je1rav/ADX-S_trusdx-audio/README.md

# ADX-S（CRkits共同購入プロジェクト）の改造

 CRkits共同購入プロジェクトで頒布されているADX-S FT8トランシーバ （https://jl1kra.sakura.ne.jp/ADX-S.html
 ) を改造し，PCとの接続をUSBコード1本にしました．  

## "trusdr-audio"によるPCとのUSB接続
ADX-Sは，uSDXプロジェクトの中でWB2CBAが開発したシンプルなデジタルモードトランシーバーADXを，BD6CRが受信部をシングルスーパーに改造・キット化し，CRkitsで頒布されているものです．  
一方，元々のATmega328をフル活用したSDRトランシーバーuSDX（元々，PE1NNZが開発）については，DL2MANがPE1NNZの協力のもとで，(tr)uSDXとして発展させています．  https://dl2man.de/  
この(tr)uSDXプロジェクトの中で，デジタルモードについてUSBシリアル通信でAudio信号伝送とCATを同時に行う方法が開発されています．  
これは，"trusdx-audio"と呼ばれ，PC側のpythonプログラムと(tr)uSDX側のファームウェアによって実現されています．  
PC側のpythonプログラムはOlgierd(https://github.com/olgierd/trusdx-audio/
 )によるオリジナル版を，PE1NNZ(uSDXのファームウェア開発者，threeme3)が発展させ，Windows版のインストーラー付きのパッケージとして配布されています．  
<s>https://github.com/threeme3/trusdx-audio/  （trusdx-audioの詳細はこれらのページをご覧ください．）</s>  
現在は，(tr)uSDXのサイトhttps://dl2man.de/4-trusdx-manual/
で配布されています．

これを利用して，ADX-Sでも同様にUSBケーブル1本で，Audio信号伝送とCATを同時に行うことにしました．  
送信周波数の決定手法は，https://github.com/je1rav/QP-7C_RP2040
を参照ください．  

ハードウェアは，ADC入力用にオーディオアンプの追加が必要で，メイン基板上にオーディオアンプICを直接配線しました．  

ADX-Sのファームウェアは，(tr)uSDXのCATのドキュメントとtrusdx-audioのpythonプログラムを参照しながら作りました．  
<DEL>”trusdx-audio”のデータ分解能は8bitと低いので，PCへの入力データは大きめが良いようです．  
受信感度は，プログラムの1214行目の割り算の分母を調節してみてください．（大きくすると強度が下がり，小さくすると上がります．）</DEL>  
ADCの感度を自動調整するようにしました．  
これでもWSJT-Xの入力インディケータが赤色になり続ける場合は，ATTをonにしてみてください(現時点ではATTは自動にonにはなりません)．  
受信感度は，オーディオケーブルを使用した場合と同程度でした．

具体的な改造は以下の2点です．  

### 1．ADX-Sメイン基板への追加配線 
#### CD2003の出力信号をATmega328PのADC端子に接続するために，CD2003のDET_OUT(11番ピン)とArduino Nano互換ボードのA2ピン(21番ピン)の間にオーディオアンプを挿入します．  
	このアンプは，メイン基板表側とフロントパネルの間に配置しました．
	オーディオアンプにはLM386をゲイン20倍で使用しました．
	2番ピンをCD2003のDET_OUT(11番ピン)に1uFのコンデンサを介して接続します．
	3番ピン，4番ピンをGNDに接続し，6番ピンを5V電源(Arduino Nanoの+5Vピン)に接続します．
	5番ピンをArduino Nano互換ボードのA2ピンに接続します(電源電圧の1/2のオフセット電圧が発生し，ADCへの接続には最適です)．
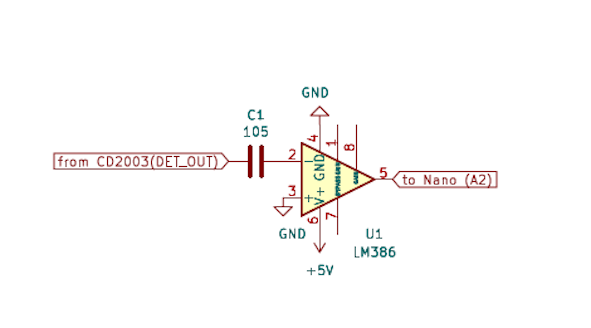
[picture p1: images/ADX-S_trusdx-audio_1.png]
回路図
 
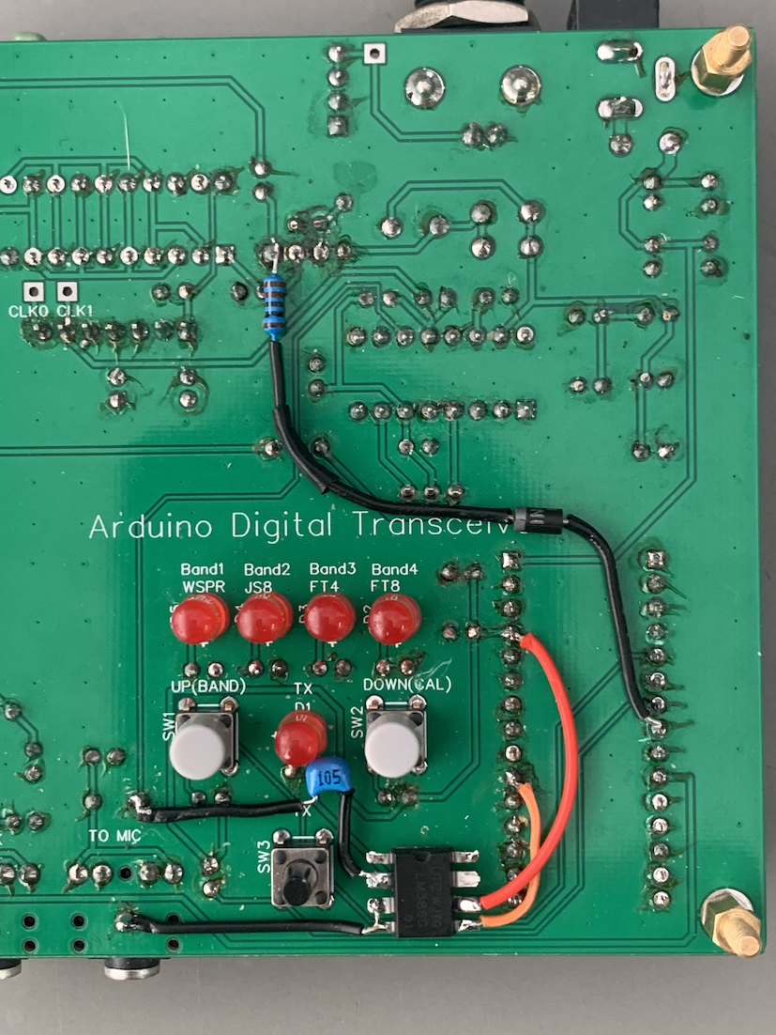
[picture p2: images/ADX-S_trusdx-audio_2.png]
メイン基板表側_配線
  
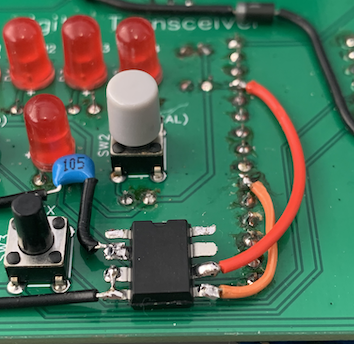
[picture p3: images/ADX-S_trusdx-audio_3.png]
メイン基板表側_配線拡大図
  

#### 事前にADX-SのATT, AGC改造をお薦めします(改造を行ったADX-Sでテストしました,中央写真のダイオードと抵抗はATT改造の配線です．)  

### 2．ファームウェア  
#### ADX_S_V1.3JP_trusdr-audio.inoです．    
	ADX-S用のプログラムADX_S_V1.3JP.inoを元にしています．    
	https://jl1kra.sakura.ne.jp/ADX_S_V1.3JP.ino    
	(JP版とWorld Wide版の違いは，40mバンドのJS8モードの設定周波数です(JP版では，JS8に日本ローカルFT8用の7041kHzが設定されている)．）  
	uSDXでは，TS480をシミュレートしてCATを行なっているので，シミュレート対象をTS2000からTS480に変更しました．  
 	送信用音声信号のサンプリング速度などの問題で，2500Hz以上の音響周波数はうまく周波数測定ができないようなので，送信周波数は2500Hz以下にしてください．　
   	(ファームウェアの設定を変えて，2500Hzより高周波まで対応することは可能ですが，そうするとFT4が使えなくなると思われます．)
	 
### ファームウェアのインストール  
	ADX-Sのファームウェアの書き込みはArduino IDE環境下で行います．  
	PC(Windows)へのtrusdx-audioのインストール方法や使用方法はPE1NNZ(threeme3)のgithubを参照ください．
	https://github.com/threeme3/trusdx-audio/
	元々のtrusdx-audioと(tr)uSDXの組み合わせでは，PTT方式はWindowsではCATとRTS/DTRが使用可能です．
	しかし，今回のADX-Sのファームウェアの都合上，PTT方式はCATのみの対応です． 
	リグ設定は”TS480"を選択してください．
 	ハンドシェイクはなし(N)にし，制御信号の強制設定はしないでください．
  
	PC側でtrusdx-audioプログラムを作動させなければ，元のままで動きます．
 	（CATを使用する場合のリグ設定はTS480， ハンドシェイクはなし(N)，制御信号の強制設定はしない，PTTはVOXに設定）．
	Hamlibの挙動はよくわかりません．

  	AndroidスマホのFT8CNでも，リグ設定を"(tr)uSDX(audio over cat)"に設定すれば使用可能でした(PTT方式は"CAT")．   

#### 必要部品  
	オーディオIC LM386：1個
	積層セラミックコンデンサー105：1個

## ADX-S（CRkits共同購入プロジェクト）の改造の追加 （2024/3/18）
最初にテストした時の受信アンテナ(MLA, SLA)のチューニングがずれていて，アンテナ感度が低下していました．   
アンテナを調整して，調べ直した結果，元々使用していたオーディオアンプLM386のゲイン（200倍）は高すぎるようだと思われます．   
ゲイン20倍で使用した方が良さそうですので本文を変更しました．   
（元々取り付けていたLM386の1番ピンと8番ピンの間のキャパシター(10uF)を，取り付けないことにしました．）   
ファームウェア"ADX_S_V1.3JP_trusdr-audio.ino"を更新しました．　   

## ADX-S（CRkits共同購入プロジェクト）の改造の追加2 （2024/3/21）
ファームウェア"ADX_S_V1.3JP_trusdr-audio.ino"を更新しました．   
CATルーチンを少し変更しています．   
FT8CNでも安定して動くと思います．   

trusdx-audioの実行ファイルの代替え"trusdx_adx.exe.zip"をアップロードしました．   
ソースは，https://github.com/je1rav/trusdx-audio/   
解凍後に,インストール済みの"C:\Program Files (x86)\truSDX Driver\truSDX Driver.exe"の代わりに使ってください．   
元の実行ファイルとは，名前を変えています．   
送信中に起きることがあるWSJT-XからのCAT pollingを，RIGに送らずにこのプログラム中で返信します．   
このため，CAT pollingにより生じる送信周波数の乱れを防いでいます．   

## ADX-S（CRkits共同購入プロジェクト）の改造の追加3 （2024/3/26）
ファームウェア"ADX_S_V1.3JP_trusdr-audio.ino"を更新しました．   
ADCの感度を自動調整するようにしました．    
　　　
　　　
　　　

# ADX_S_V2.0_trusdr-audio
ADX-S ver2.0がリリースされました．  
ADX-S ver1で順次行われていた種々の改良に加えてLPFモジュールのバンド自動認識機能が装備され，Audio Adapter Cableが付属しています．  
また，オプションとしてBluetoothモジュールの搭載が可能となっています．  
そこで，ver2に対してもtrusdx-audioを利用するための改造を行いました．  

ADC入力用のオーディオアンプですが，今回はオプションのBluetoothモジュールの取り付けピン配線を利用し，
Bluetoothモジュールが接続されるメインボードの裏側に設置することにし，基板を作製しました．  
モジュール用の電源電圧は5Vから少し下がって4.3Vになっていますが，特に問題はありません．  
Ver1では外付部品を減らすためにLM386を使用しましたが，今回はノイズの少ないオーディオ用オペアンプを使用しました．  
これにより，受信時のノイズレベルが下がりました．  
Ver2.0ではNanoのA2ピンはLPFモジュールのバンド自動認識用に使用されているので，A3ピンにジャンパー接続します．  
Ver1と同様にアンプにLM386を使用しても，出力をA3ピンに接続すれば問題ありません．  

具体的な改造は以下の2点です．  

### 1．ADX-Sメイン基板への基板追加 
回路図．pdf 　　　

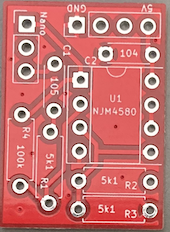
[picture p4: images/v2-amp_1.png]
基板
  
オーディオアンプ基板  

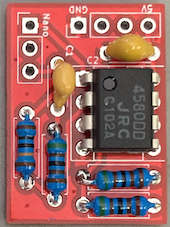
[picture p5: images/v2-amp_2.png]
基板_部品取付済
  
部品取付済み基板  

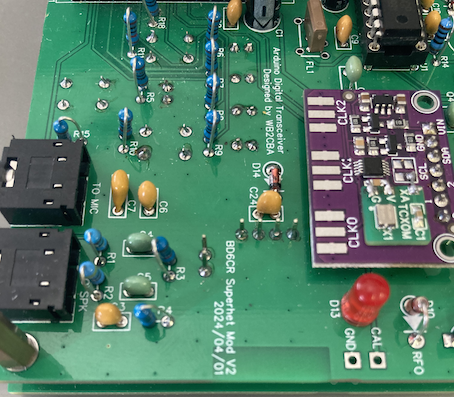
[picture p6: images/v2-amp_3.png]
メイン基板_取付前
  
メイン基板の取り付け位置（取付前）  

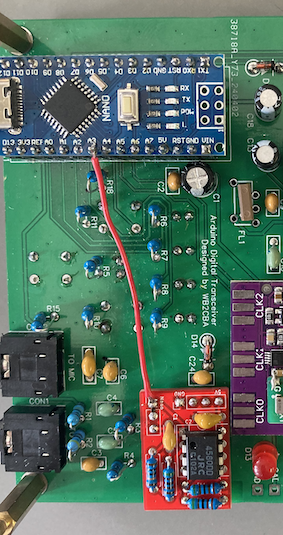
[picture p7: images/v2-amp_4.png]
メイン基板_配線
  
取り付け済みメイン基板  
出力をNanoのA3ピンにジャンパー接続　　　

オプションのBluetoothモジュールとの同時使用も可能だと思いますが，テストしていません．  
（日本でのBluetoothモジュールの使用は，技適の関係で少し厄介です(1アマを持っていれば180日以内の実験使用の手続きが可能)．）　  
Bluetoothモジュールへの音響接続回路は，オーディオケーブルを差し込むと切断されます．  
このため，この改造でもオーディオケーブルを接続すると使用不能になります．  
オーディオケーブルと同時使用したい場合には，入力側をCD2003のDET_OUT端子に直接ジャンパー接続する必要があります．  

### 2．ファームウェア  
	ADX_S_V2.0_trusdr-audio.inoです．    
	ADX-S用のプログラムADX_S_V2.0.inoを元にしています．    
	(40mバンドのJS8モードの設定周波数をJP版と同様に，Japan localのFT8の7041kHzに変更しています）  
	uSDXでは，TS480をシミュレートしてCATを行なっているので，シミュレート対象をTS2000からTS480に変更しています．  
	使用方法などはver1と同じです．  

#### JLCPCB用のガーバーファイルは"v2-amp_gerber.zip"です．  
#### Kicadファイルは"v2-amp_Kicad.zip"です．  

#### 必要部品  
	2回路オーディオオペアンプ：たとえば秋月電子NJM4580DD　1個60円　https://akizukidenshi.com/catalog/g/g100069/
	積層セラミックコンデンサー104：1個
	積層セラミックコンデンサー105：1個
	抵抗　5.1 kΩ：3個
	抵抗　100 kΩ：1個
