je1rav/ADX-S_trusdx-audio/images/v2-amp_diagram.pdf

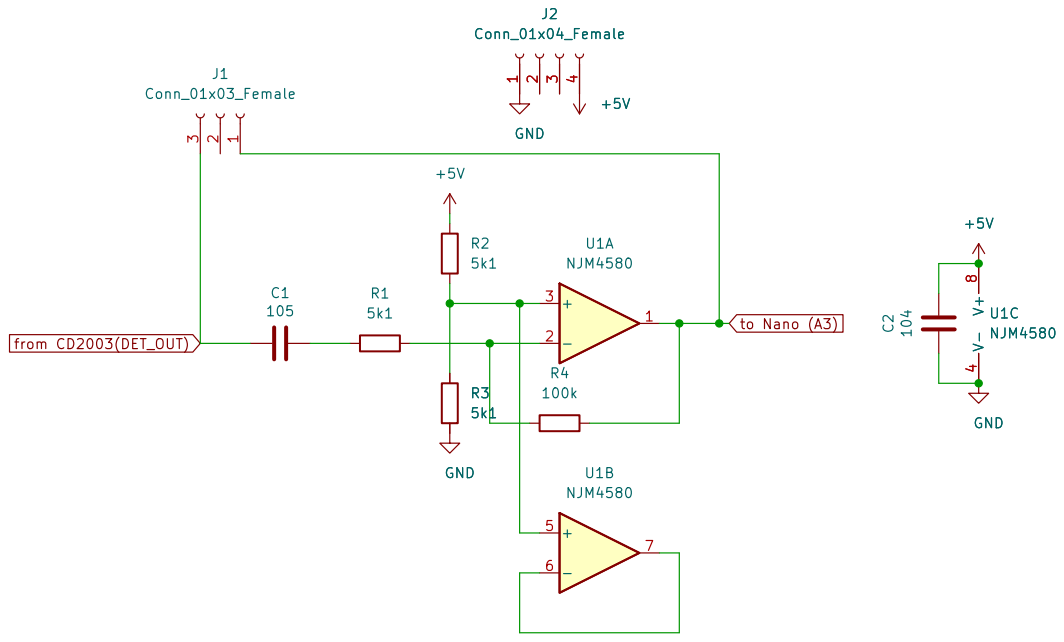
[picture p8: page 1]
